zrecore/femtoduino-ble/Eagle/femtoduinoBLE/femtoduinoBLE.brd

## EAGLE design Eagle/femtoduinoBLE/femtoduinoBLE.brd (2014-07-23)

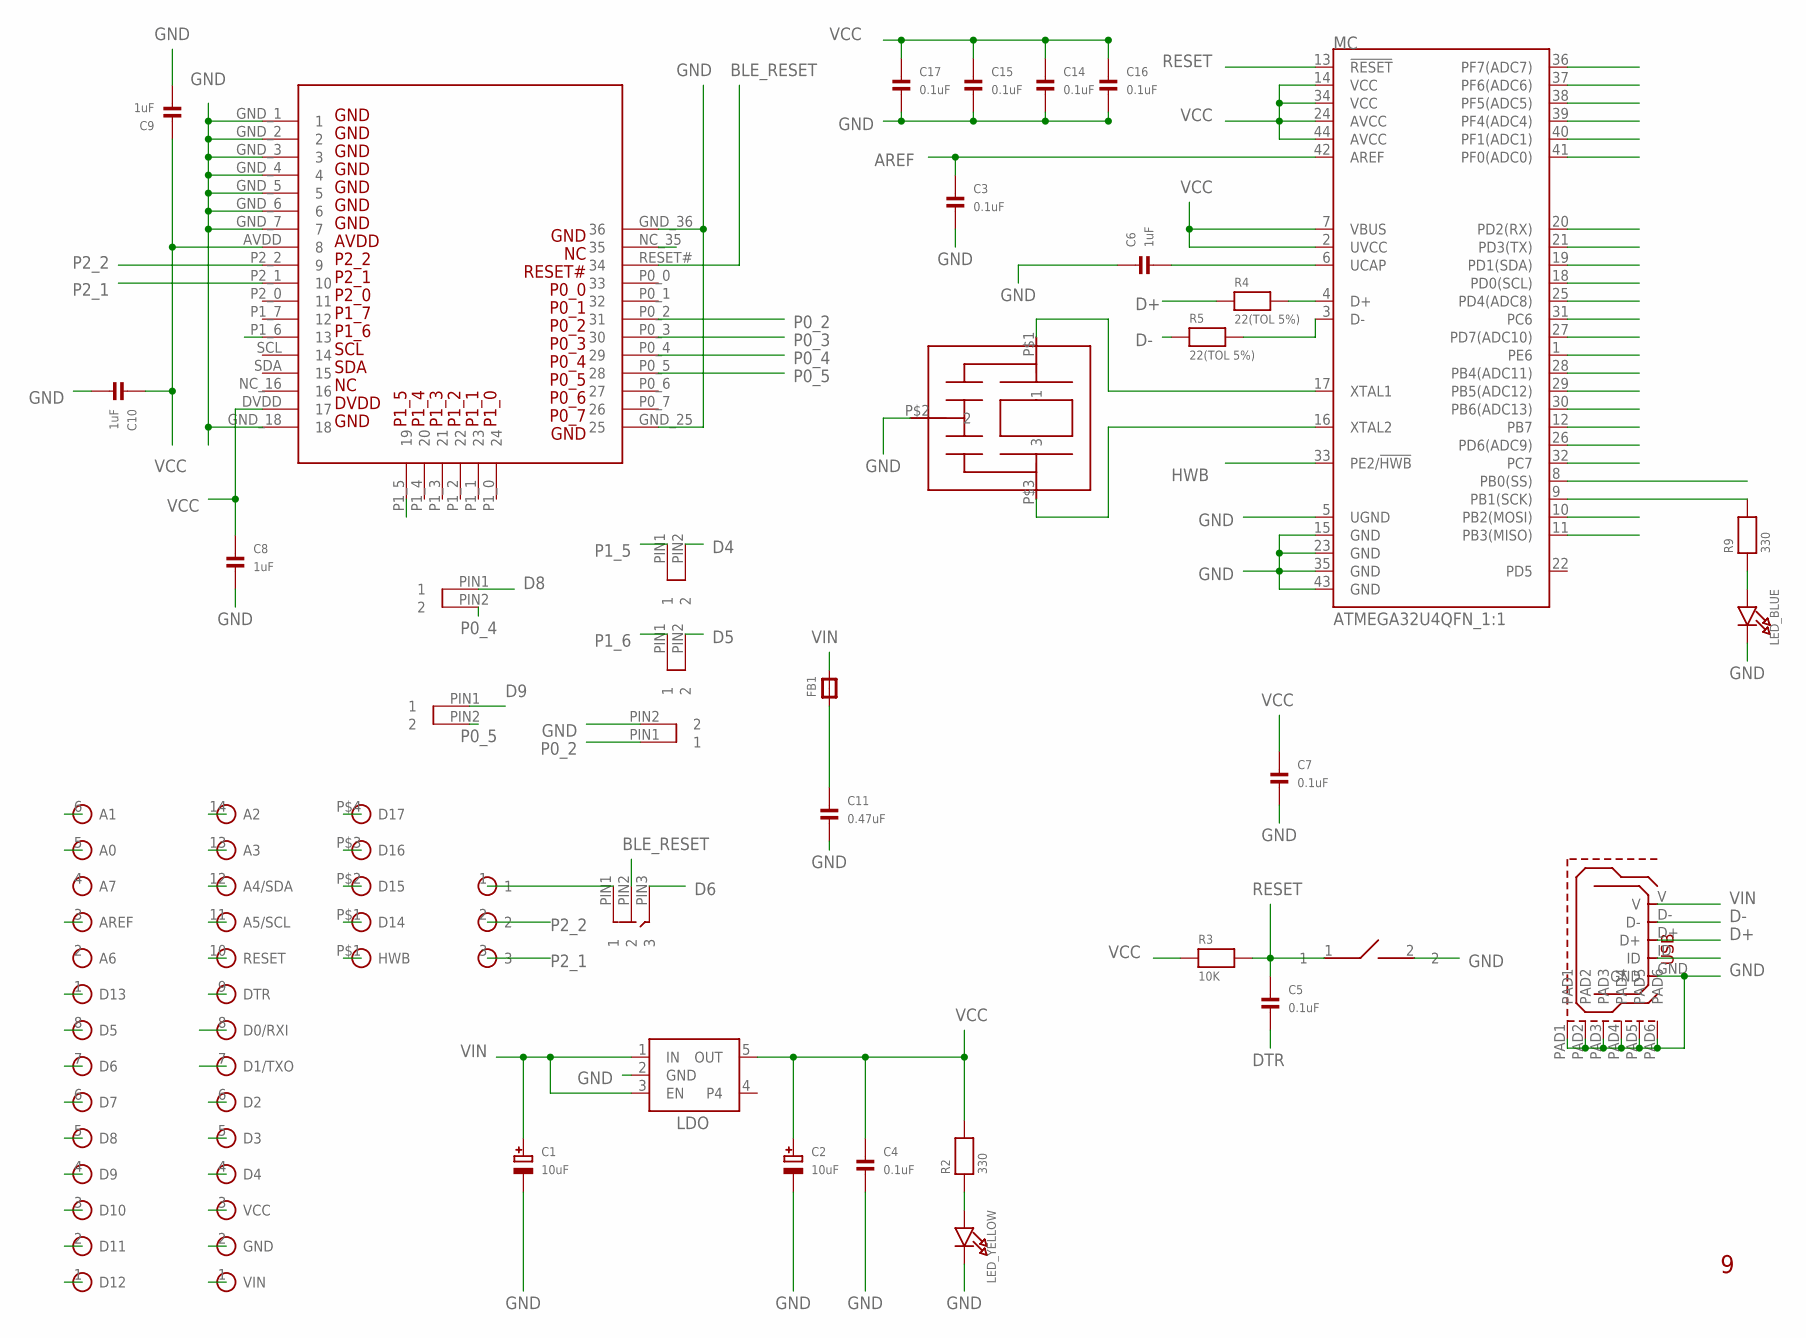
[picture p1: schematic femtoduinoBLE.sch, Femtoduino based on the Arduino Leonardo (ATMEGA32u4), with…]

Parts:
BLE_CTS: DNP; SPST_SMD_BRIDGED
C1, C2: 10uF; EIA3216-18/A-R
C3, C4, C5, C7, C14, C15, C16, C17: 0.1uF; _0402
C6: 1uF; _0402
C8, C9, C10: 1uF; 0402
C11: 0.47uF; _0402
FB1: FERRITE; 0603
LED_BLUE: LED0603_NOOUTLINE; CHIPLED_0603_NOOUTLINE
LED_YELLOW: LED0603_NOOUTLINE; CHIPLED_0603_NOOUTLINE
MC: ATMEGA32U4QFN_1:1; QFN-44-NOPAD_1:1
R2, R9: 330; _0402
R3: 10K; _0402
R4, R5: 22(TOL 5%); 0402
U$1: USB_MICROB; USB_MICROB_PACKAGE
U$2: CSTCE16MOV51-RO; CSTCE16M0V51-RO_PACKAGE
U$4: LDO_REGULATOR
U$5: 05_PINHEAD_1X6; 05_PINHEAD_1X6_PACKAGE
U$6: 05_PINHEAD_1X8; 05_PINHEAD_1X8_PACKAGE
U$7: 05_PINHEAD_1X14; 05_PINHEAD_1X14_PACKAGE
U$9: DNP; SPST_SMD
U$10: 05_PINHEAD_1X4; 05_PINHEAD_1X4_PACKAGE
U$11: 05_PINHEAD_1X1; 05_PINHEAD_1X1_PACKAGE
U$12: BLE113-A
U$13, U$14, U$15, U$16: DNP; SPST_SMD_BRIDGED
U$19: DNP; SPST_3_SMD
U$20: 05_PINHEAD_HEADER_1X3; 05_PINHEAD_1X3_HEAD_PACKAGE

Connections:
A0: MC.36 (PF7(ADC7)), U$5.5 (A0)
A1: MC.37 (PF6(ADC6)), U$5.6 (A1)
A2: MC.38 (PF5(ADC5)), U$7.14 (A2)
A3: MC.39 (PF4(ADC4)), U$7.13 (A3)
A4: MC.40 (PF1(ADC1)), U$7.12 (A4/SDA)
A5: MC.41 (PF0(ADC0)), U$7.11 (A5/SCL)
AREF: C3.1, MC.42 (AREF), U$5.3 (AREF)
BLE_RESET: U$12.RESET# (34), U$19.PIN2 (2)
D2: MC.19 (PD1(SDA)), U$7.6 (D2)
D3: MC.18 (PD0(SCL)), U$7.5 (D3)
D4: MC.25 (PD4(ADC8)), U$7.4 (D4), U$16.PIN2 (2)
D5: MC.31 (PC6), U$6.8 (D5), U$15.PIN2 (2)
D6: MC.27 (PD7(ADC10)), U$6.7 (D6), U$19.PIN3 (3)
D7: MC.1 (PE6), U$6.6 (D7)
D8: MC.28 (PB4(ADC11)), U$6.5 (D8), U$13.PIN1 (1)
D9: MC.29 (PB5(ADC12)), U$6.4 (D9), U$14.PIN1 (1)
D10: MC.30 (PB6(ADC13)), U$6.3 (D10)
D11: MC.12 (PB7), U$6.2 (D11)
D12: MC.26 (PD6(ADC9)), U$6.1 (D12)
D13: MC.32 (PC7), U$5.1 (D13)
D14: MC.11 (PB3(MISO)), U$10.P$1 (D14)
D15: MC.9 (PB1(SCK)), R9.2, U$10.P$2 (D15)
D16: MC.10 (PB2(MOSI)), U$10.P$3 (D16)
D17: MC.8 (PB0(SS)), U$10.P$4 (D17)
D+: R4.1, U$1.D+
D-: R5.1, U$1.D-
DTR: C5.2, U$7.9 (DTR)
GND: BLE_CTS.PIN2 (2), C1.-, C2.-, C3.2, C4.2, C6.1, C7.2, C8.2, C9.2, C10.2, C11.2, C14.2, C15.2, C16.2, C17.2, LED_BLUE.C, LED_YELLOW.C, MC.5 (UGND), MC.15 (GND), MC.23 (GND), MC.35 (GND), MC.43 (GND), U$1.GND, U$1.PAD1, U$1.PAD2, U$1.PAD3, U$1.PAD4, U$1.PAD5, U$1.PAD6, U$2.P$2 (2), U$4.2 (GND), U$7.2 (GND), U$9.2, U$12.GND_1 (1), U$12.GND_2 (2), U$12.GND_3 (3), U$12.GND_4 (4), U$12.GND_5 (5), U$12.GND_6 (6), U$12.GND_7 (7), U$12.GND_18 (18), U$12.GND_25 (25), U$12.GND_36 (36)
HWB: MC.33 (PE2/!HWB), U$11.P$1
unnamed: C11.1, FB1.1
unnamed: LED_BLUE.A, R9.1
unnamed: LED_YELLOW.A, R2.1
unnamed: U$19.PIN1 (1), U$20.1
unnamed: MC.4 (D+), R4.2
unnamed: MC.3 (D-), R5.2
P0_2: BLE_CTS.PIN1 (1), U$12.P0_2 (31)
P0_3: U$12.P0_3 (30)
P0_4: U$12.P0_4 (29), U$13.PIN2 (2)
P0_5: U$12.P0_5 (28), U$14.PIN2 (2)
P1_5: U$12.P1_5 (19), U$16.PIN1 (1)
P1_6: U$12.P1_6 (13), U$15.PIN1 (1)
P2_1: U$12.P2_1 (10), U$20.3
P2_2: U$12.P2_2 (9), U$20.2
RESET: C5.1, MC.13 (!RESET), R3.2, U$7.10 (RESET), U$9.1
RXI: MC.20 (PD2(RX)), U$7.8 (D0/RXI)
TXO: MC.21 (PD3(TX)), U$7.7 (D1/TXO)
UCAP: C6.2, MC.6 (UCAP)
VCC: C2.+, C4.1, C7.1, C8.1, C9.1, C10.1, C14.1, C15.1, C16.1, C17.1, MC.2 (UVCC), MC.7 (VBUS), MC.14 (VCC), MC.24 (AVCC), MC.34 (VCC), MC.44 (AVCC), R2.2, R3.1, U$4.5 (OUT), U$7.3 (VCC), U$12.AVDD (8), U$12.DVDD (17)
VIN: C1.+, FB1.2, U$1.V, U$4.1 (IN), U$4.3 (EN), U$7.1 (VIN)
XTAL1: MC.17 (XTAL1), U$2.P$1 (1)
XTAL2: MC.16 (XTAL2), U$2.P$3 (3)

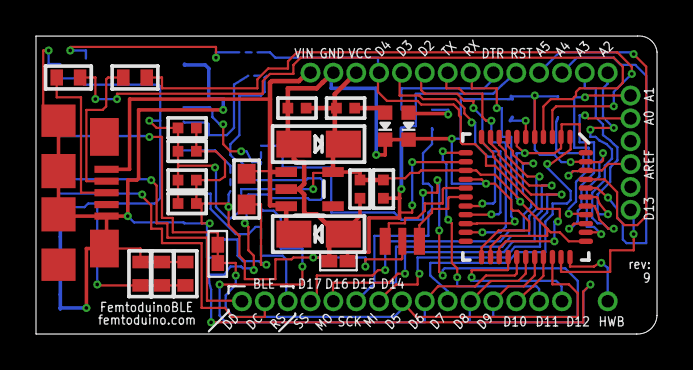
[picture p2: board femtoduinoBLE.brd from above]

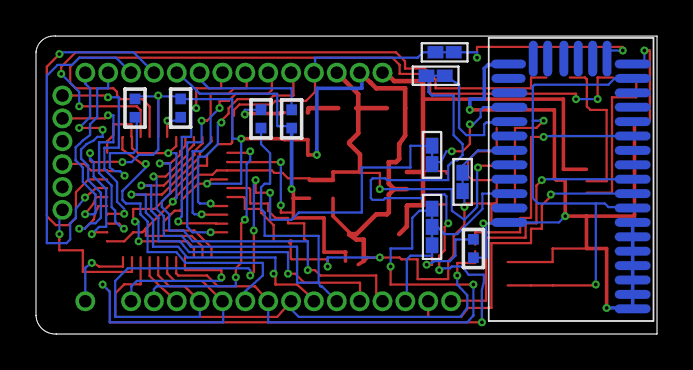
[picture p3: board femtoduinoBLE.brd from below]

Board: 4 copper layers, 34.5 x 16.6 mm, 41 parts (11 on the bottom side), 50 nets.
