zrecore/femtoduino-ble/(commit log)

2014-02-25 Adding Arduino and Android code
2014-07-23 EAGLE PCB schematics and board files, BoM and parts
    [femtoduinoBLE.bom.csv, femtoduinoBLE.brd, femtoduinoBLE.sch]
